DitroniX/GTEM-Grid-Tie-Energy-Monitor/Certification/README.md

**Certification Documentation - External**

These Certification Documents pertain to the related Manufacturer MCU, covering both Wireless and Bluetooth RF Testing.

Further information can be found:

- **Website** https://ditronix.net/
- **WIKI**  https://ditronix.net/wiki/
- **GitHub**  https://github.com/DitroniX/
- **Shop**  https://ditronix.net/shop/
- **Hackster.io** https://www.hackster.io/ditronix

Dave Williams | G8PUO | DitroniX 1981-2024 | ditronix.net
