DitroniX/GTEM-Grid-Tie-Energy-Monitor/Datasheets and Information/README.md

**GTEM ESP32 ATM90E26 Energy Monitor SDK**

------------

This folder contains applicable datasheets and GTEM design information.

Further information can be found:

- **Website** https://ditronix.net/
- **WIKI**  https://ditronix.net/wiki/
- **GitHub**  https://github.com/DitroniX/
- **Shop**  https://ditronix.net/shop/
- **Hackster.io** https://www.hackster.io/ditronix

Dave Williams | G8PUO | DitroniX 1981-2024 | ditronix.net
