DitroniX/GTEM-Grid-Tie-Energy-Monitor/Datasheets and Information/GTEM ESP32 ATM90E26 Enery Monitor Connections.jpg

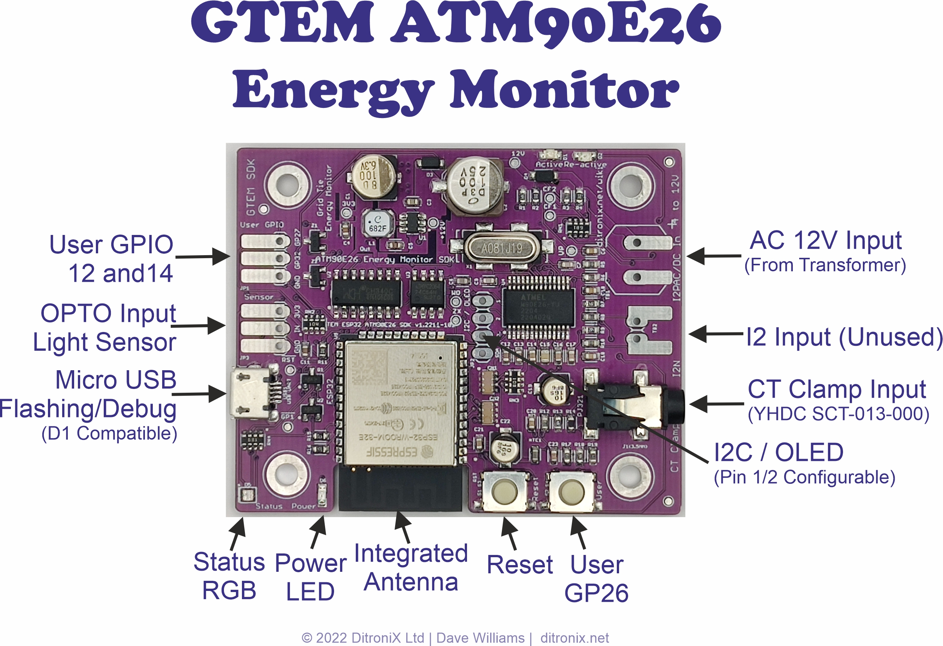
Datasheets and Information/GTEM ESP32 ATM90E26 Enery Monitor Connections.jpg
