DitroniX/GTEM-Grid-Tie-Energy-Monitor/Datasheets and Information/GTEM ESP32 ATM90E26 SDK v1 2212-104 PCB 3D Top Angled.png

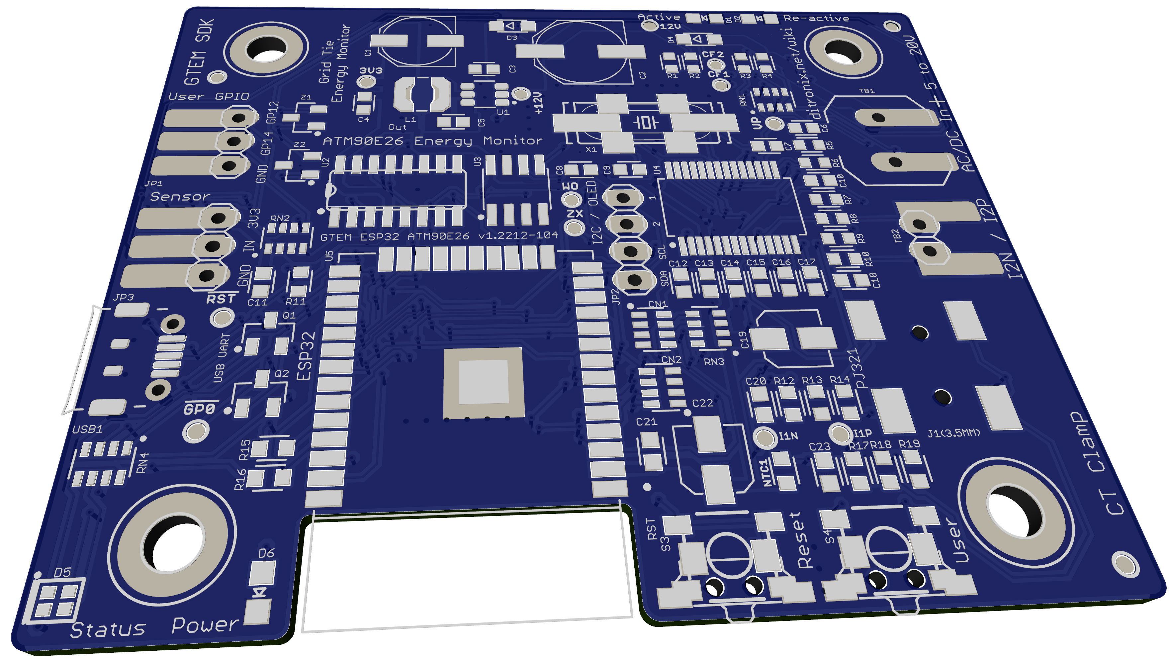
Datasheets and Information/GTEM ESP32 ATM90E26 SDK v1 2212-104 PCB 3D Top Angled.png
