DitroniX/GTEM-Grid-Tie-Energy-Monitor/Datasheets and Information/GTEM ESP32 ATM90E26 v1 2212-104 - PCB Kit Angled.jpg

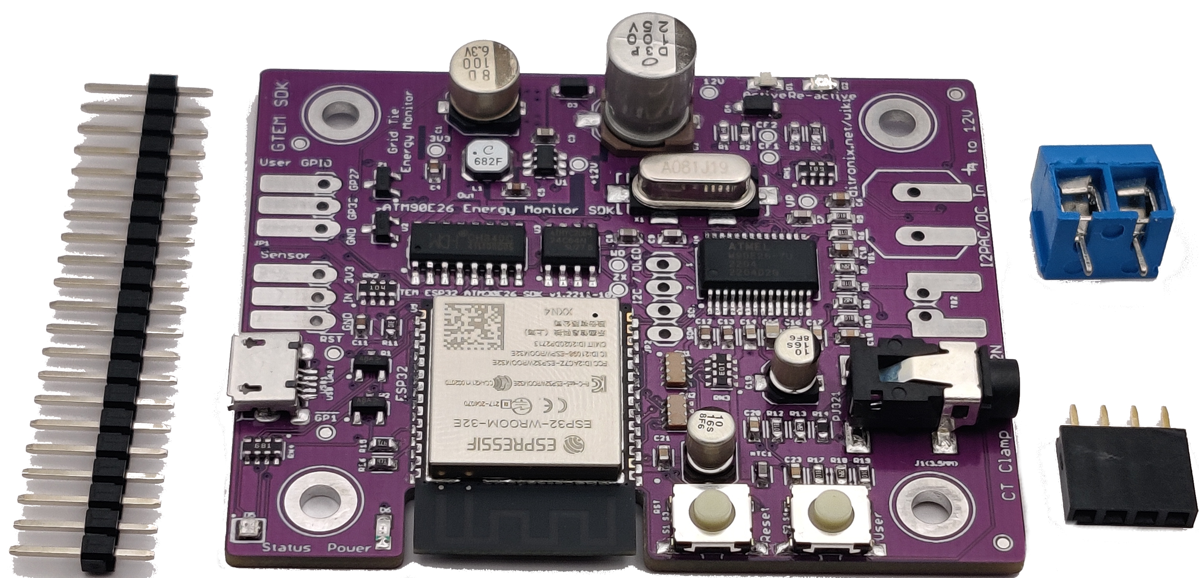
Datasheets and Information/GTEM ESP32 ATM90E26 v1 2212-104 - PCB Kit Angled.jpg
