DitroniX/GTEM-Grid-Tie-Energy-Monitor/Datasheets and Information/GTEM ESP32 ATM90E26 SDK v1 2212-105 - PCB Components.png

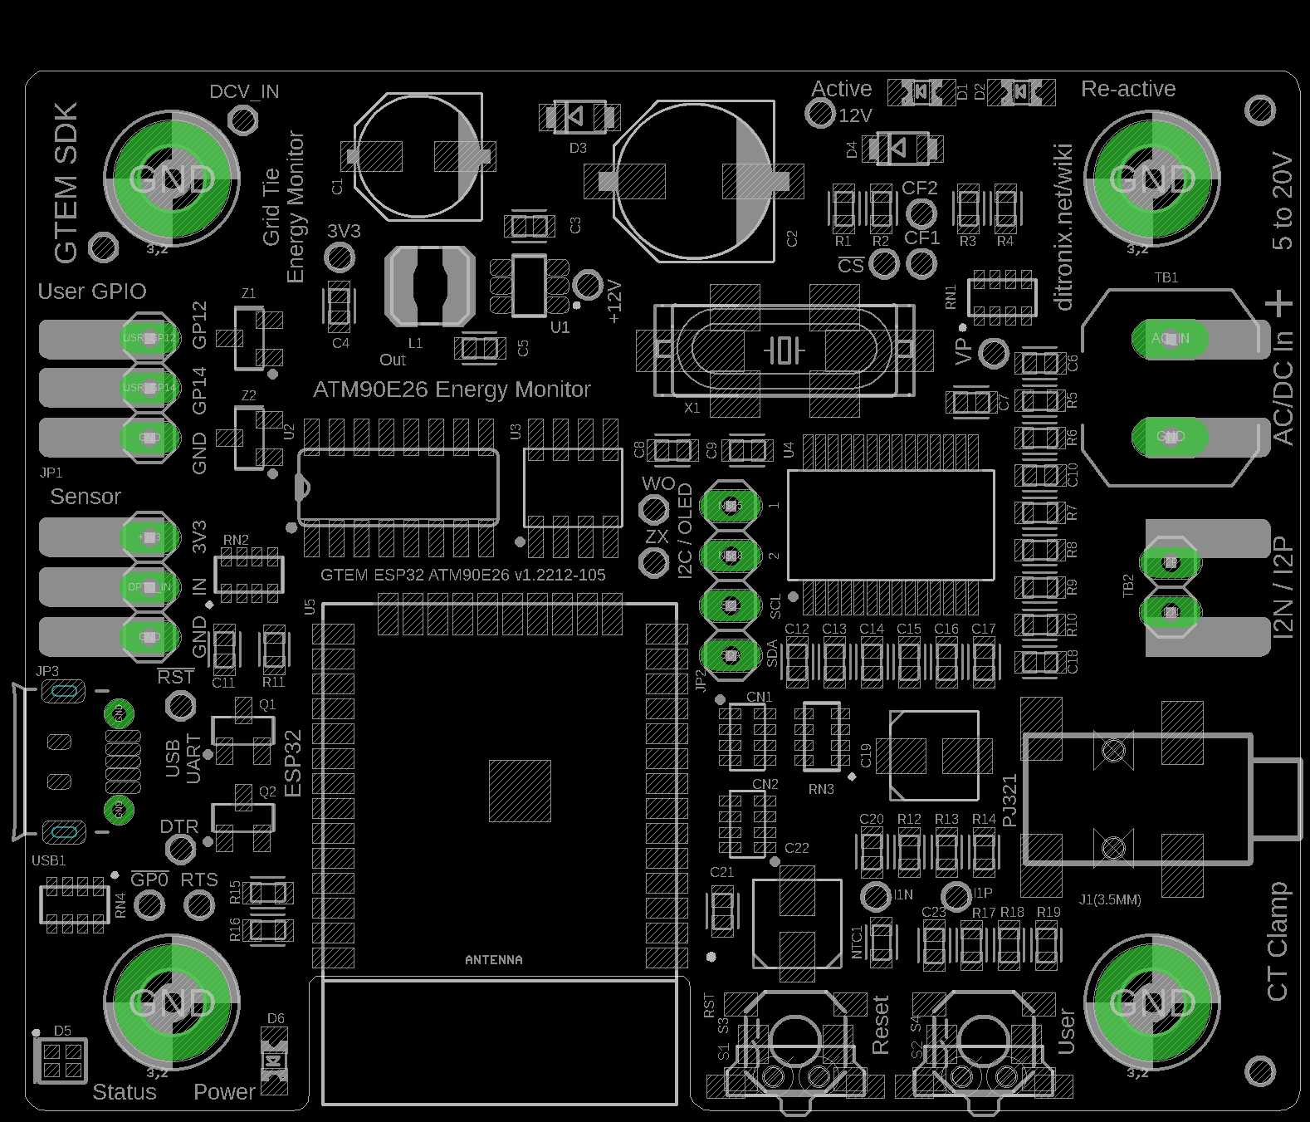
Datasheets and Information/GTEM ESP32 ATM90E26 SDK v1 2212-105 - PCB Components.png
