DitroniX/GTEM-Grid-Tie-Energy-Monitor/Datasheets and Information/Energy Setpoint Calculator GTEM Bring-Up Only.xlsx

Voltage ratio | 0.0009965122073 | Vout/Vin | Based on your input voltage divider ratios |  |  |  |  |  | L Line Input Impedance | 1000 | Ohm
Current ratio | 0.0145631068 | Vout/Ain | Based on your input current shunt/CT ratios |  |  |  |  |  | V Channel Input Impedance | 400 | kOhm
 |  |  |  |  |  |  |  |  |  |  |  |  |  |  | Impulse converter
MMode |  |  |  |  |  |  |  |  |  |  |  |  |  |  | 973 | W
Lgain= | 100: Gain 1 |  |  |  | 100 |  |  |  |  | 1000000000 |  |  |  |  | 3.699897225 | seconds per impulse |  |  | 0.2702777778 | Hz
Ngain= | 10: Gain 1 |  |  |  | 10 |  |  |  |  |  |  |  |  |  | 973 | impulses in one hour |  |  | 0.2197802198 | Hz
LNSel= | 1: Meter on L line |  |  |  | 1
DisHPF= | 00: HPF1 and HPF0 |  |  |  | 00
Amod= | 0: Fwd or rev energy pulse output |  |  |  | 0
Rmod= | 0: Fwd or rev reactive energy pulse output |  |  |  | 0
Zxcon= | 10: All zero crossing |  |  |  | 10
Pthresh= | 0010: 3.125% |  |  |  | 0010
Mmode Reg= | 1001010000100010 |  |  |  |  |  |  |  |  |  |  | 0.1125728155
= | 10010100 | 00100010
= | 94 | 22
Mmode Reg= | 0x9422
 |  |  |  |  |  |  |  |  |  |  | DWX
PL Constant |  |  |  |  |  |  |  |  |  |  | XLS Example
UN= | 220 | V | Reference voltage, unit is V |  |  |  |  |  |  |  | 220
Ib= | 1 | A | Basic current, unit is A |  |  |  |  |  |  |  | 1
GL= | 24 | V/V | L line current circuit gain |  |  |  |  | Register 2BH - b15 b14 b13 |  |  | 24
VL= | 5.600 | mV | Sampling voltage of the L line circuit at Ib, unit is mV |  |  |  |  | CT Clamp Voltage Across I1N and I1P |  |  | 5.6
VU= | 190.000 | mV | Sampling voltage of the voltage circuit at UN, unit is mV |  |  |  |  | RMS Voltage to VP (After Divider) |  |  | 274.66 |  | 100k/1k | 12V RMS Transfoirder = 19.2V RMS |  |  | Vu= | 190.6 | Vu = (1k / (100k + 1k)) *19.2
MC= | 1000 | imp/kWh | Pulse constant of the energy meter, unit is imp/kWh |  |  |  |  |  |  |  | 3200
 |  |  |  |  | Workings
PL_Constant= | 97368860 |  |  |  | 25536 | GL*VL*VU
= | 05CDBB1C |  |  |  | 220000 | MC*UN*IB
PLconstH(0x21)= | 0x05CD |  | PL Constant MSB |  | 0.1160727273
PLconstL(0x22)= | 0xBB1C |  | PL Constant LSB |  | 97368860.86
Small-Power Mode and Power Offset Compensation
1. Disconnect the current circuit of the energy meter;
2. Write '0xA987' to the SmallPMod register (04H) to enter small-power mode
3. Read out L / N line active / reactive power in small-power mode many times to get a mean value;
4. Write the complement of the above mean value to the corresponding L / N line active / reactive power offset registers;
5. Write any non-0xA987 value to the SmallPMod register (04H) to exit small-power mode
L Line Gain Calibration (Calibrate PL Constant Energy Metering)
L line gain calibration is performed when power factor PF=1.0 and the current is Ib
ETSA Frequency | 0.269 | Hz | Pulse output frequency as measured from ETSA metering using photodiode.
My Frequency | 0.219 | Hz | Pulse output frequency as measured from my energymeter using photodiode.
Error % = | -18.58736059 | %
Lratio = | 0.2283105023 |  |  | 65536 |  | 1010 | 10 | 5
Lgain= | 7481 |  | 58054 |  |  | 0101
Lgain= | 0x1D39
Voltage RMS Gain and L Line Current RMS Gain
Vol_mea= | 248 | V | Readout value of the Urms register (49H) |  |  |  |  |  |  | 0.006048780488 |  |  | 10168000
Un= | 248 | V | Actual Voltage |  |  |  |  |  |  | 0.2471350274 | 40.8570005 |  | 41000
Ugainold= | 41000 |  | 26400 is the default value
= | 41000
Ugain= | 0xA028
Cur_meaL= | 10 | A | Readout value of the Urms register (49H)
Ib= | 10 | A | Actual Voltage
Igainold= | 32251 |  | 31251 is the default value
= | 32251
Igain= | 0x7DFB |  |  | offset=0.003A |  | IgainL | 377
 |  |  |  |  |  |  | 179
The current offset calibration should be performed at reference voltage and no current.
Calibration is performed by reading the current, multiplying it with the above Igain/2^16 and 2^8,
calculating the complement and writing the result to the L line current offset register (IoffsetL, 35H).
Calibration of voltage offset is similar to that of current offset, but voltage offset
calibration is not applicable for self-powered meter
Voltage Sag Setpoint
Un= | 230 | Nominal voltage
Ugain= | 41000 | From Voltage RMS Gain calc
x%= | 0.94 | 6% below nominal
SagTh = | 6109
SagTh = | 0x17DD
