DitroniX/GTEM-Grid-Tie-Energy-Monitor/Code/GTEM-1_Test_ATM90E26_Basic_Calibration-Domoticz/Energy Setpoint Calculator GTEM Bring-Up Only.xlsx

Voltage ratio | 0.0009965122073 | Vout/Vin | Based on your input voltage divider ratios |  |  |  |  |  | L Line Input Impedance | 1000 | Ohm
Current ratio | 0.0145631068 | Vout/Ain | Based on your input current shunt/CT ratios |  |  |  |  |  | V Channel Input Impedance | 400 | kOhm
 |  |  |  |  |  |  |  |  |  |  |  |  |  | Impulse converter
MMode |  |  |  |  |  |  |  |  |  |  |  |  |  | 973 | W
Lgain= | 100: Gain 1 |  |  |  | 100 |  |  |  |  | 1000000000 |  |  |  | 3.699897225 | seconds per impulse | 0.2702777778 | Hz
Ngain= | 10: Gain 1 |  |  |  | 10 |  |  |  |  |  |  |  |  | 973 | impulses in one hour | 0.2197802198 | Hz
LNSel= | 1: Meter on L line |  |  |  | 1
DisHPF= | 00: HPF1 and HPF0 |  |  |  | 00
Amod= | 0: Fwd or rev energy pulse output |  |  |  | 0
Rmod= | 0: Fwd or rev reactive energy pulse output |  |  |  | 0
Zxcon= | 10: All zero crossing |  |  |  | 10
Pthresh= | 0010: 3.125% |  |  |  | 0010
Mmode Reg= | 1001010000100010 |  |  |  |  |  |  |  |  |  |  | 0.1125728155
= | 10010100 | 00100010
= | 94 | 22
Mmode Reg= | 0x9422
PL Constant
UN= | 300.00 | V | Reference voltage, unit is V
Ib= | 12.00 | A | Basic current, unit is A
GL= | 1.00 | V/V | L line current circuit gain
VL= | 298.95 | mV | Sampling voltage of the L line circuit at Ib, unit is mV
VU= | 174.8 | mV | Sampling voltage of the voltage circuit at UN, unit is mV
MC= | 1000 | imp/kWh | Pulse constant of the energy meter, unit is imp/kWh
PL_Constant= | 12173811
= | 00B9C1F3
PLconstH(0x21)= | 0x00B9
PLconstL(0x22)= | 0xC1F3
Small-Power Mode and Power Offset Compensation
1. Disconnect the current circuit of the energy meter;
2. Write '0xA987' to the SmallPMod register (04H) to enter small-power mode
3. Read out L / N line active / reactive power in small-power mode many times to get a mean value;
4. Write the complement of the above mean value to the corresponding L / N line active / reactive power offset registers;
5. Write any non-0xA987 value to the SmallPMod register (04H) to exit small-power mode
L Line Gain Calibration (Calibrate PL Constant Energy Metering)
L line gain calibration is performed when power factor PF=1.0 and the current is Ib |  |  |  |  |  |  |  |  |  |  | Default
ETSA Frequency | 0.269 | Hz | Pulse output frequency as measured from ETSA metering using photodiode. |  |  |  |  |  |  |  | 0.269 |  | Lgain Does not seem to have any affect on Ugain or Igain
My Frequency | 0.219 | Hz | Pulse output frequency as measured from my energymeter using photodiode. |  |  |  |  |  |  |  | 0.219
Error % = | -18.58736059 | % |  |  |  |  |  |  |  |  |  |  | Calibration Defaults. If updated, CRC is autocalculated upon boot and re-read from EEPROM.
Lratio = | 0.2283105023 |  |  | 65536 |  | 1010 | 10 | 5 |  |  |  |  | Simply use XLS to approxi,ate calculate UGAIN and IGAIN. Enter below and 'Upload'. CRC will auto calcualte.
Lgain= | 7481 |  | 58054 |  |  | 0101 |  |  |  |  |  |  | Remember that the mains voltage continuously changes slightly! You will see this when monitoring.
Lgain= | 0x1D39 |  |  |  |  |  |  |  |  |  |  |  | NB. Testing was done with a pure sinewave inverter (TLC SK 652100) to give constant 230v and a Resistive fixed load.
 |  |  |  |  |  |  |  |  |  |  |  |  | If the current clamp is correctly placed and current reduces on load - simply reverse the transformer AC in!
 |  |  |  |  |  |  |  |  |  |  |  |  | Example Values
Voltage RMS Gain |  |  |  |  |  |  |  | Temp |  |  |  |  | 8V AC RMS In
Vol_mea= | 159.23 | V |  | Readout value of the Urms register (49H) |  |  |  | 159.1 | 0.005686785714 |  |  |  | 158.4
Un= | 246.10 | V |  | Actual Voltage |  |  |  | 244.1 | 0.2452416542 | 43.12482772 |  |  | 246
Ugainold= | 28000 |  |  | 26400 is the default value |  |  |  |  |  |  |  |  | _lgain = 0x1D39; // Use XLS to calculate these values, PL CONSTANT. Examples: 0x1D39;
 |  |  |  |  |  |  |  |  |  |  |  |  | _ugain = 0xA028; // Use XLS to calculate these VOLTAGE RMS values. Examples: 8V 0xA028 | 12V 0x9F9A or 0x9E38
 |  |  |  |  |  |  |  |  |  |  |  |  | _igain = 0x7160; // Use XLS to calculate these CURRENT GAIN values. Examples: 0x7160;
= | 43275
Ugain= | 0xA90B |  |  | Will require CRC2 to be updated (GTEM-1_Defaults)
L Line Current RMS Gain
Cur_meaL= | 0.56 | A |  | Readout value of the Urms register (49H) |  |  |  | 1.6 | 35
Ib= | 0.80 | A |  | Actual Current |  |  |  | 1.486 | 25 |  |  |  | 12V AC RMS In
Igainold= | 40000 |  |  | 31251 is the default value |  |  |  |  |  |  |  |  | 159.1
 |  |  |  |  |  |  |  |  |  |  |  |  | 244.1
 |  |  |  |  |  |  |  |  |  |  |  |  | _lgain = 0x1D39; // PL CONSTANT. Use XLS to calculate these values. Examples: 0x1D39;
 |  |  |  |  |  |  |  |  |  |  |  |  | _ugain = 0xA083; // VOLTAGE RMS. Use XLS to calculate these values. Examples: 8V 0xA028 | 12V 0x9F9A or 0x9E38
= | 57142 |  |  | Based on a YHDC SCT-013 100A/50mA Current Transformer |  |  |  |  |  |  |  |  | _igain = 0x9153; // CURRENT GAIN. Use XLS to calculate these values. Examples: 0x7160; 0x9897; 0x8DF2;
Igain= | 0xDF36 |  |  | Will require CRC2 to be updated (GTEM-1_Defaults) |  |  |  |  | offset=0.003A |  | IgainL | 669
 |  |  |  |  |  |  |  |  |  |  |  | 29D | CRC Now Auto Calculated in this release.
The current offset calibration should be performed at reference voltage and no current.
Calibration is performed by reading the current, multiplying it with the above Igain/2^16 and 2^8, |  |  |  |  |  |  |  |  |  |  |  |  | The above example values are what I have used on GTEM to test. Based on YHDC SCT-013 100A/50mA Current Transformer and DAT01A Mains Transformer
calculating the complement and writing the result to the L line current offset register (IoffsetL, 35H). |  |  |  |  |  |  |  |  |  |  |  |  | These WILL vary from one setup to another due to tolerances or the components, clamp and transformer.
 |  |  |  |  |  |  |  |  |  |  |  |  | Dave Williams, DitroniX
Calibration of voltage offset is similar to that of current offset, but voltage offset
calibration is not applicable for self-powered meter |  |  |  |  |  |  |  |  |  |  |  |  | Ugain Does not have any affect on Igain - and Visa Versa. It will however, have an influece on Power
Voltage Sag Setpoint
Un= | 230 | Nominal voltage
Ugain= | 43275 | From Voltage RMS Gain calc
x%= | 0.94 | 6% below nominal
SagTh = | 5787
SagTh = | 0x169B
