DitroniX/GTEM-Grid-Tie-Energy-Monitor/(commit log)

2022-12-23 GTEM Initial Bring Up Test Code
    [Energy Setpoint Calculator GTEM Bring-Up Only.xlsx]
2022-12-30 Create GTEM ESP32 ATM90E26 SDK v1 2212-104 Under Test.jpg
2022-12-30 Create ESP32-WROOM-32 Pin Connections.png
2023-01-04 VSCode Calibration and Domoticz Updates
2023-01-04 Schematic Updates
2023-01-05 Create GTEM ESP32 Interfacing.md
2023-01-05 Update GTEM ESP32 Interfacing.md
2023-01-05 Create GTEM ESP32 ATM90E26 SDK v1 2212-104 AC Power Supply Test.jpg
2023-01-05 Update DitroniX.net Board Versions and Revisions.txt
2023-01-06 Update GTEM ATM90E26 Registers.xlsx
    [GTEM ATM90E26 Registers.xlsx]
2023-01-06 PCB Photos
2023-01-06 Create GTEM ESP32 ATM90E26 Enery Monitor Connections.jpg
2023-01-23 GTEM Import/Export Power. Improvements to Domoticz
    [Energy Setpoint Calculator GTEM Bring-Up Only.xlsx]
2023-01-25 AT24C64 EEPROM Enabled. Automatic CRC Update Upon Calibration Default Changes.
    [Energy Setpoint Calculator GTEM Bring-Up Only.xlsx]
2023-04-21 Create ESP32-WROOM-32E Datasheet.pdf
2023-05-22 Minor Updates
    [Energy Setpoint Calculator GTEM Bring-Up Only.xlsx]
2023-08-05 Power Energy Monitor Boards SDK Overview
